chinart123/ESP32-QUADCOPTER-/assets/sender-receiver-flow.drawio.png

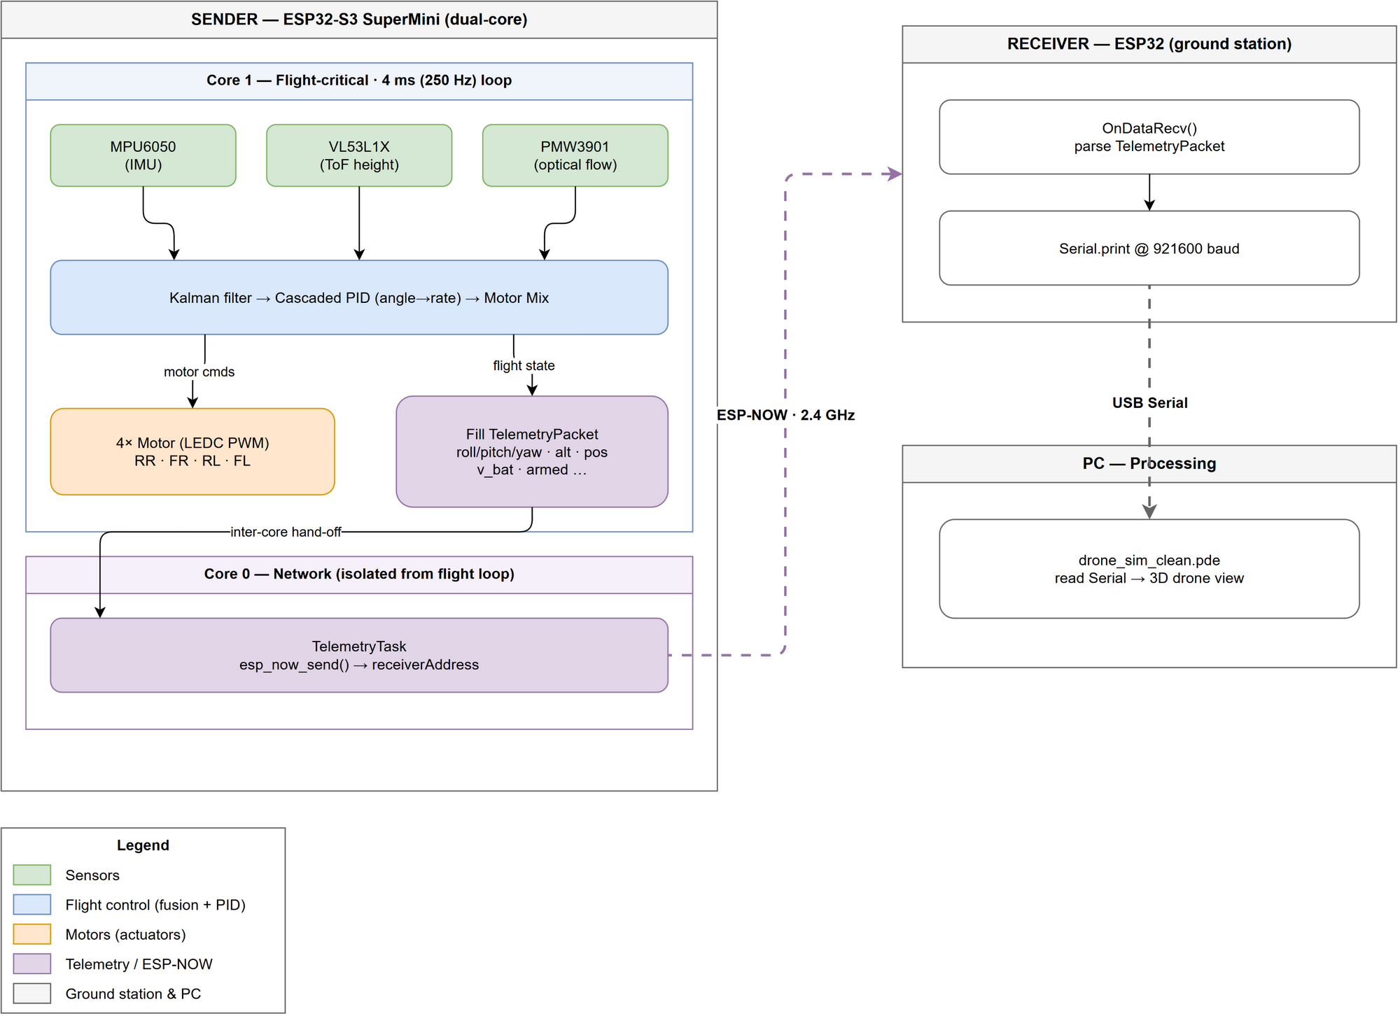
assets/sender-receiver-flow.drawio.png
