chinart123/ESP32-QUADCOPTER-/(commit log)

2026-07-05 docs: add sender to receiver data flow diagram
    Dual-core sender (Core 1 flight-critical / Core 0 network) -> ESP-NOW
    -> receiver -> Serial -> Processing 3D sim. Source .drawio plus PNG
    preview and editable (embedded-XML) PNG.
2026-07-05 docs: add per-module architecture diagrams
    One .drawio per module folder under docs/:
    - esp32-dual-core-rtos: FreeRTOS dual-core task model
    - mpu6050: IMU + attitude estimation + cascaded attitude PID
    - vl53l1x: ToF height + cascaded altitude-hold PID
    - pmw3901: optical-flow odometry + cascaded position-hold PID
    - telemetry-esp-now: ESP-NOW link + TelemetryPacket wire format
    - telemetry-processing-app: serial parse + 3D digital twin
2026-07-06 docs: clean up wireless section of sender-receiver-flow diagram
2026-07-06 docs: fix label collision in esp32-dual-core-rtos diagram
2026-07-06 docs: declutter mpu6050-algorithm (remove arrow crossing RL motor)
2026-07-06 docs: redesign esp32-dual-core-rtos (drop orphan chip, clean vertical shared-state arrows)
